ZeniteSolar/MDE18/Diagrama de blocos.docx

Leme

Conversor de torque 133:1

Popa do barco

Arduino Nano
Atmega 328P

Potenciometro Blindado
10k ohms

Bateria aux
12V

Ponte H
Modulo BTS7960
43 Amp.

Motor DC 12v

Proa do barco

Direção

Arduino Nano
Atmega 328P

Potenciometro Blindado
10k ohms

Comunicação CAN

12v DC
