ZeniteSolar/MDE18/schematics/microcontrolador popa.PDF

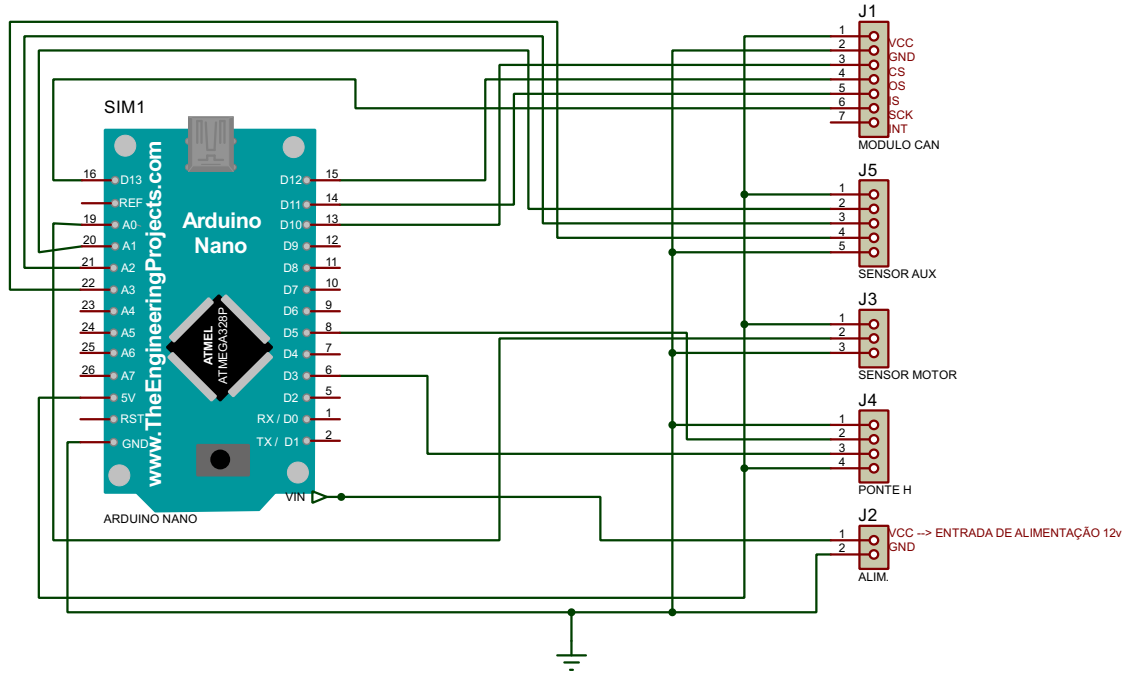
[picture p1: page 1]

ATMEGA328P ATMEL www.TheEngineeringProjects.com D12 D11 D10 D9D8D7D6D5D4D3D2 RX / D0 GND TX / D1 RST 5VA7A6A5A4A3A2A1A0 REF D13 Arduino Nano 12567891011121314 16 15 2423222120192526 SIM1 ARDUINO NANO 1234567 J1MODULO CAN 12 J2ALIM.VCC GND CSOSISSCK INT VCC GND 123 J3SENSOR MOTOR 1234 J4PONTE H VIN --> ENTRADA DE ALIMENTAÇÃO 12v 12345 J5SENSOR AUX
