ZeniteSolar/MDE18/schematics/microcontrolador proa.PDF

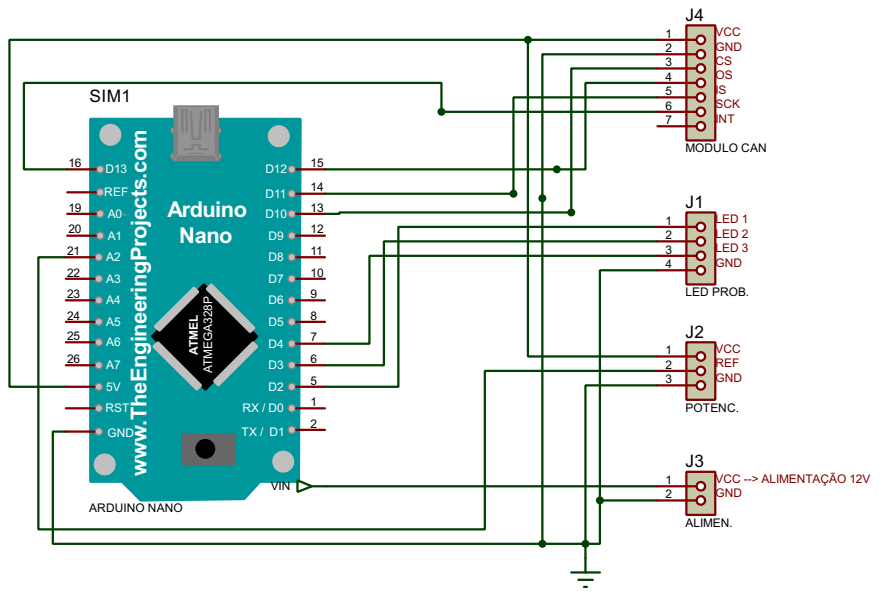
[picture p2: page 1]

ATMEGA328P ATMEL www.TheEngineeringProjects.com D12 D11 D10 D9D8D7D6D5D4D3D2 RX / D0 GND TX / D1 RST 5VA7A6A5A4A3A2A1A0 REF D13 Arduino Nano 12567891011121314 16 15 2423222120192526 SIM1 ARDUINO NANO VCC GND CSOSISSCK INT 123 J2POTENC. 12 J3ALIMEN. 1234567 J4MODULO CAN 1234 J1LED PROB. LED 1 LED 2 LED 3 GND VCC REF GND VIN VCC --> ALIMENTAÇÃO 12V GND
