ZeniteSolar/MDE18/Visio-diagrama inicial.pdf

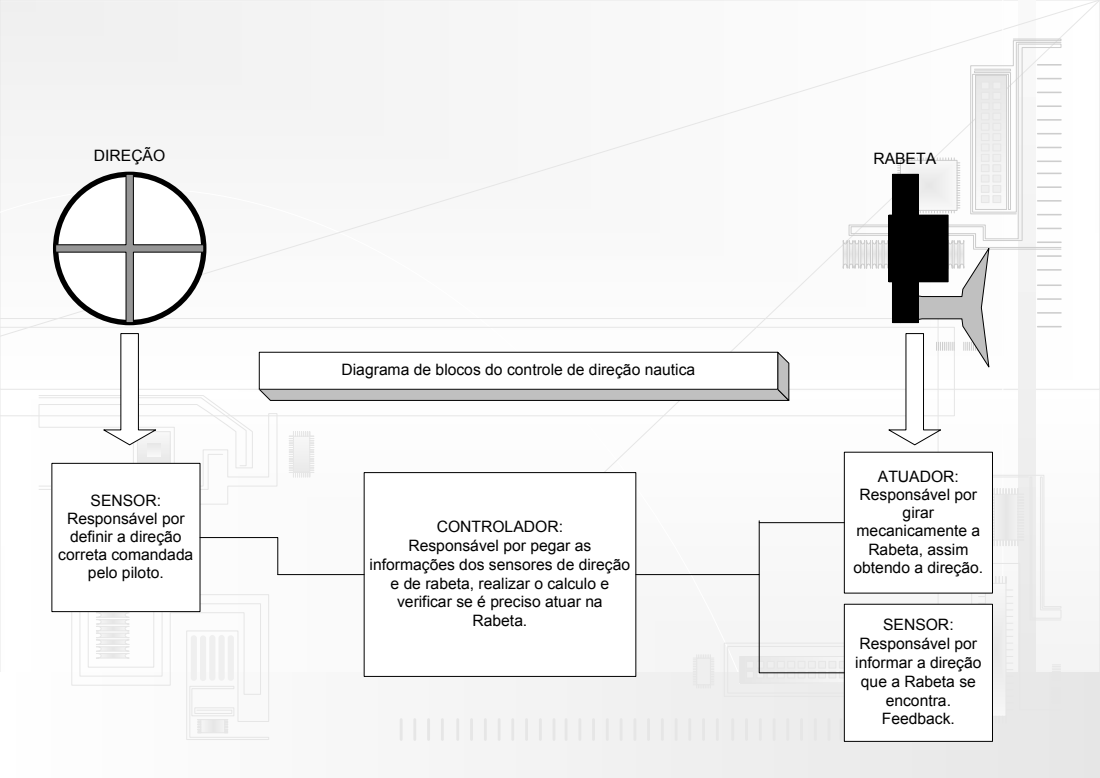
[picture p3: page 1]
DIREÇÃO; SENSOR: Responsável por definir a direção correta comandada pelo piloto.; RABETA; ATUADOR: Responsável por girar mecanicamente a Rabeta, assim obtendo a direção.; Rabeta.

Diagrama de blocos do controle de direção nautica

CONTROLADOR:
Responsável por pegar as
informações dos sensores de direção
e de rabeta, realizar o calculo e
verificar se é preciso atuar na

SENSOR:
Responsável por
informar a direção
que a Rabeta se
encontra.
Feedback.
