ZeniteSolar/MDE18/schematics/COMPLETO.PDF

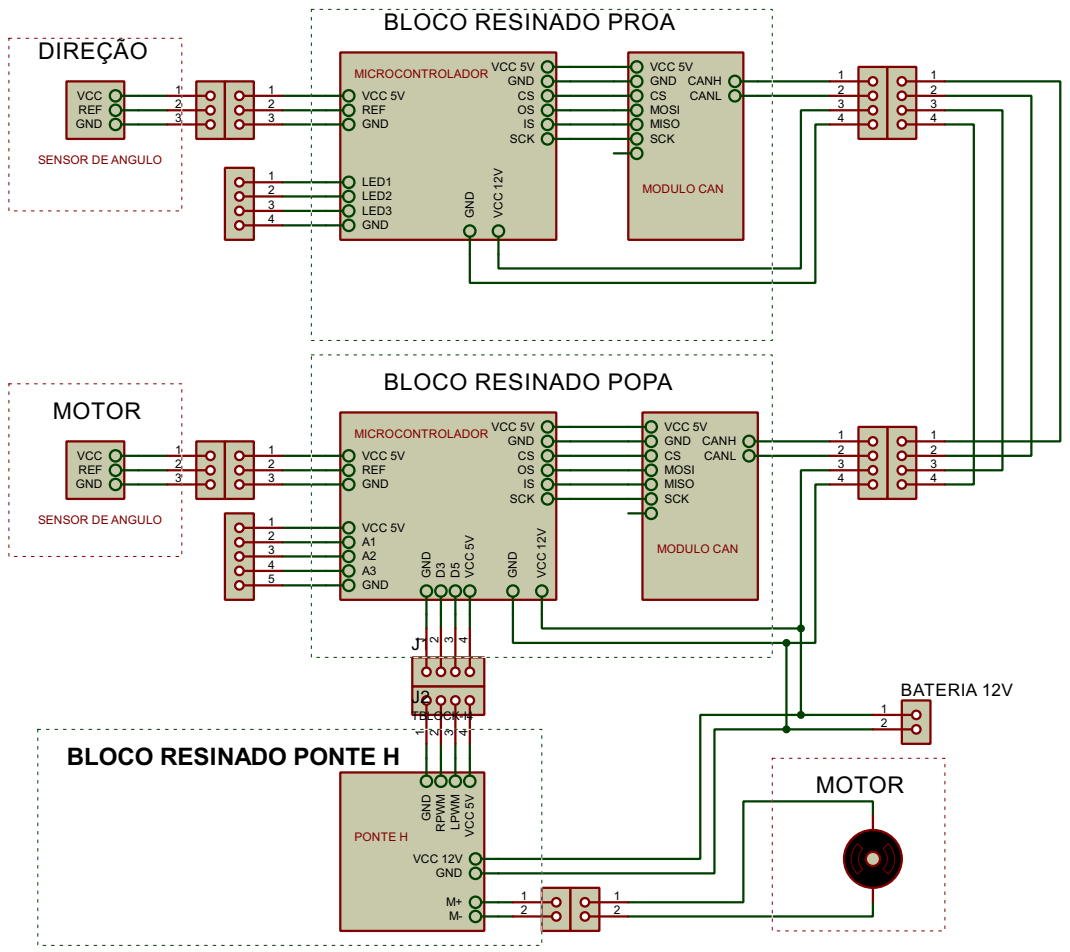
[picture p4: page 1]

IS | | | | 4 | 4
SCK | SCK MODULO CAN
