ZeniteSolar/MDE18/schematics/MODULO CAN.PDF

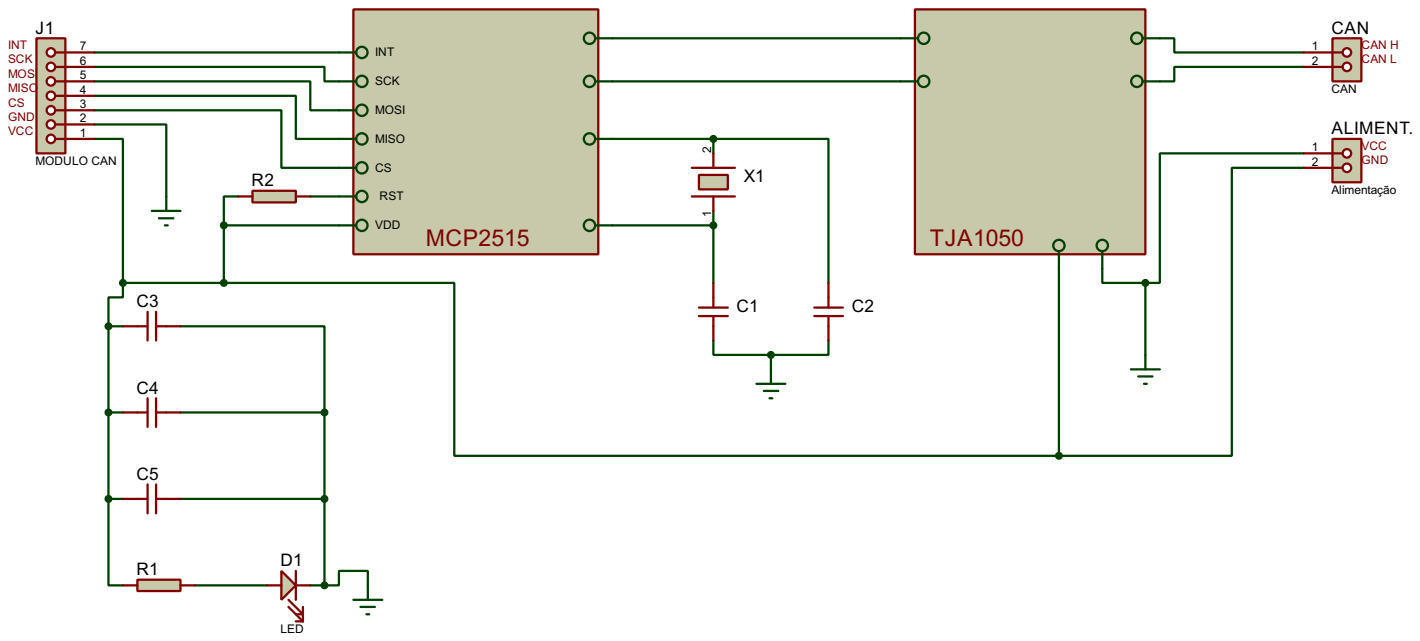
[picture p5: page 1]
