ZeniteSolar/MDE18/schematics/MODULO PONTE H.PDF

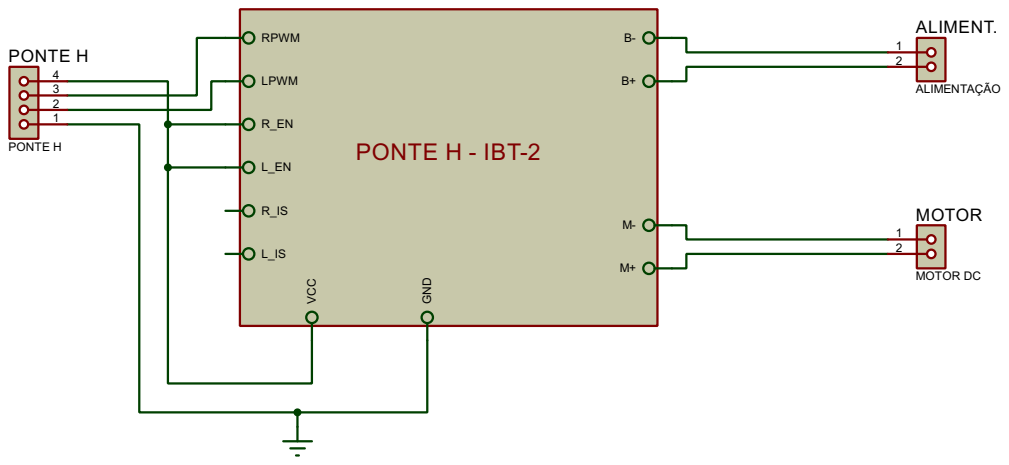
[picture p6: page 1]
