ZeniteSolar/MDE18/schematics/SENSOR ANGULO.PDF

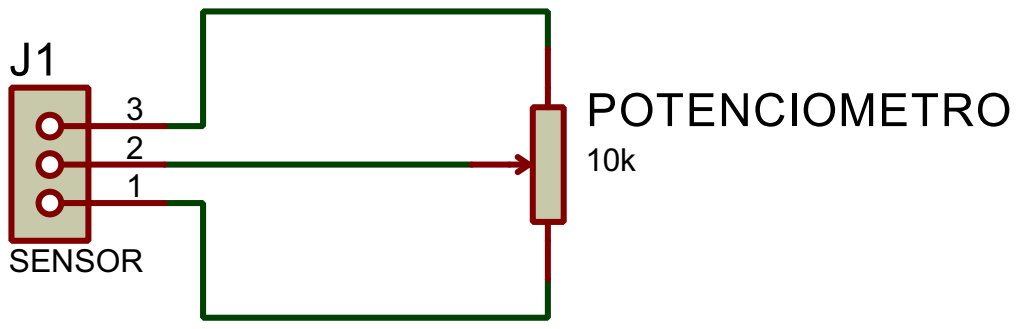
[picture p7: page 1]
