ZeniteSolar/MDE18/hardware/popa/layout_rabeta.pdf

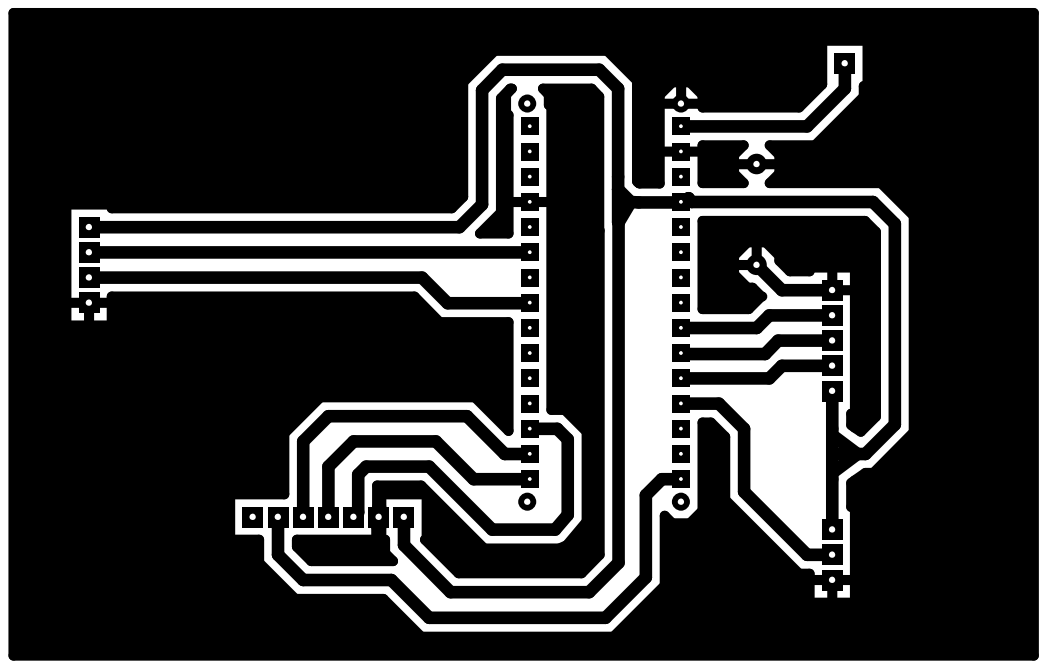
[picture p8: page 1]
