ZeniteSolar/MDE18/hardware/popa/layout_rabeta_borda1.pdf

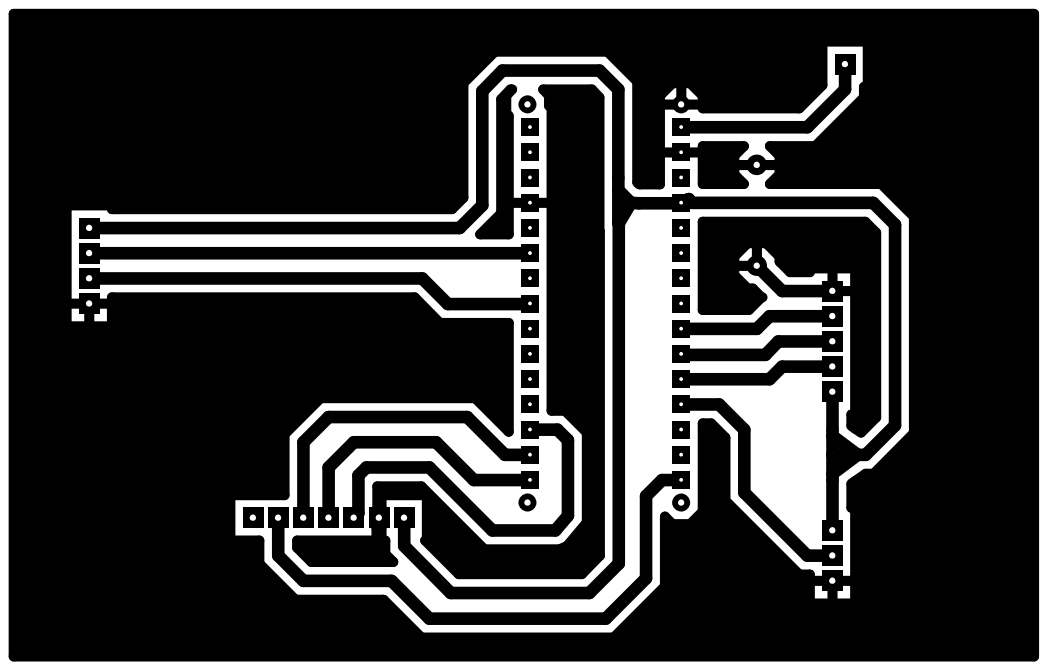
[picture p9: page 1]
