ZeniteSolar/MDE18/hardware/proa/layout_direcao_borda.pdf

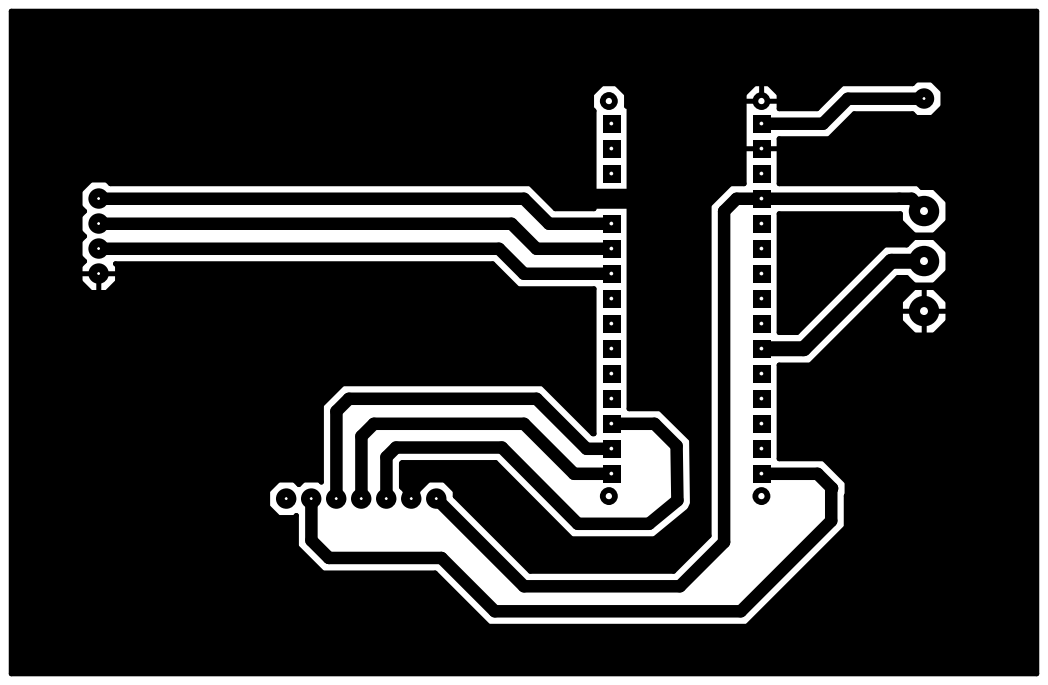
[picture p10: page 1]
