ZeniteSolar/MDE18/(list of files, drawings)

Other design files:
hardware/popa/rabeta.pdsprj
hardware/proa/direcao.pdsprj
