ZeniteSolar/MDE18/(commit log)

2022-03-17 Arquivos originais do TCC do Cesar Dias Parente.
    [direcao.pdsprj, rabeta.pdsprj]
2022-03-21 fixup! Bring MDE to our CAN Application protocol, refactor the code and rename variables to be more consistent with the literature.
    [rabeta_can_pont_erro_teste1106.ino]
2022-03-21 Fix spaces on serial messages
    [rabeta_can_pont_erro_teste1106.ino]
2022-03-21 Name motor I/O's
2022-03-21 Add CAN filters and mask
2022-03-21 Improve CAN error messages
    [rabeta_can_pont_erro_teste1106.ino]
2022-03-21 Set MCP2515 to 8MHz, fix position_setpoint when no can msgs are received
    [rabeta_can_pont_erro_teste1106.ino]
